adafruit/Adafruit_ADXL343_PCB/Adafruit ADXL343 STEMMA QT.brd

## EAGLE design Adafruit ADXL343 STEMMA QT.brd (2022-03-22)

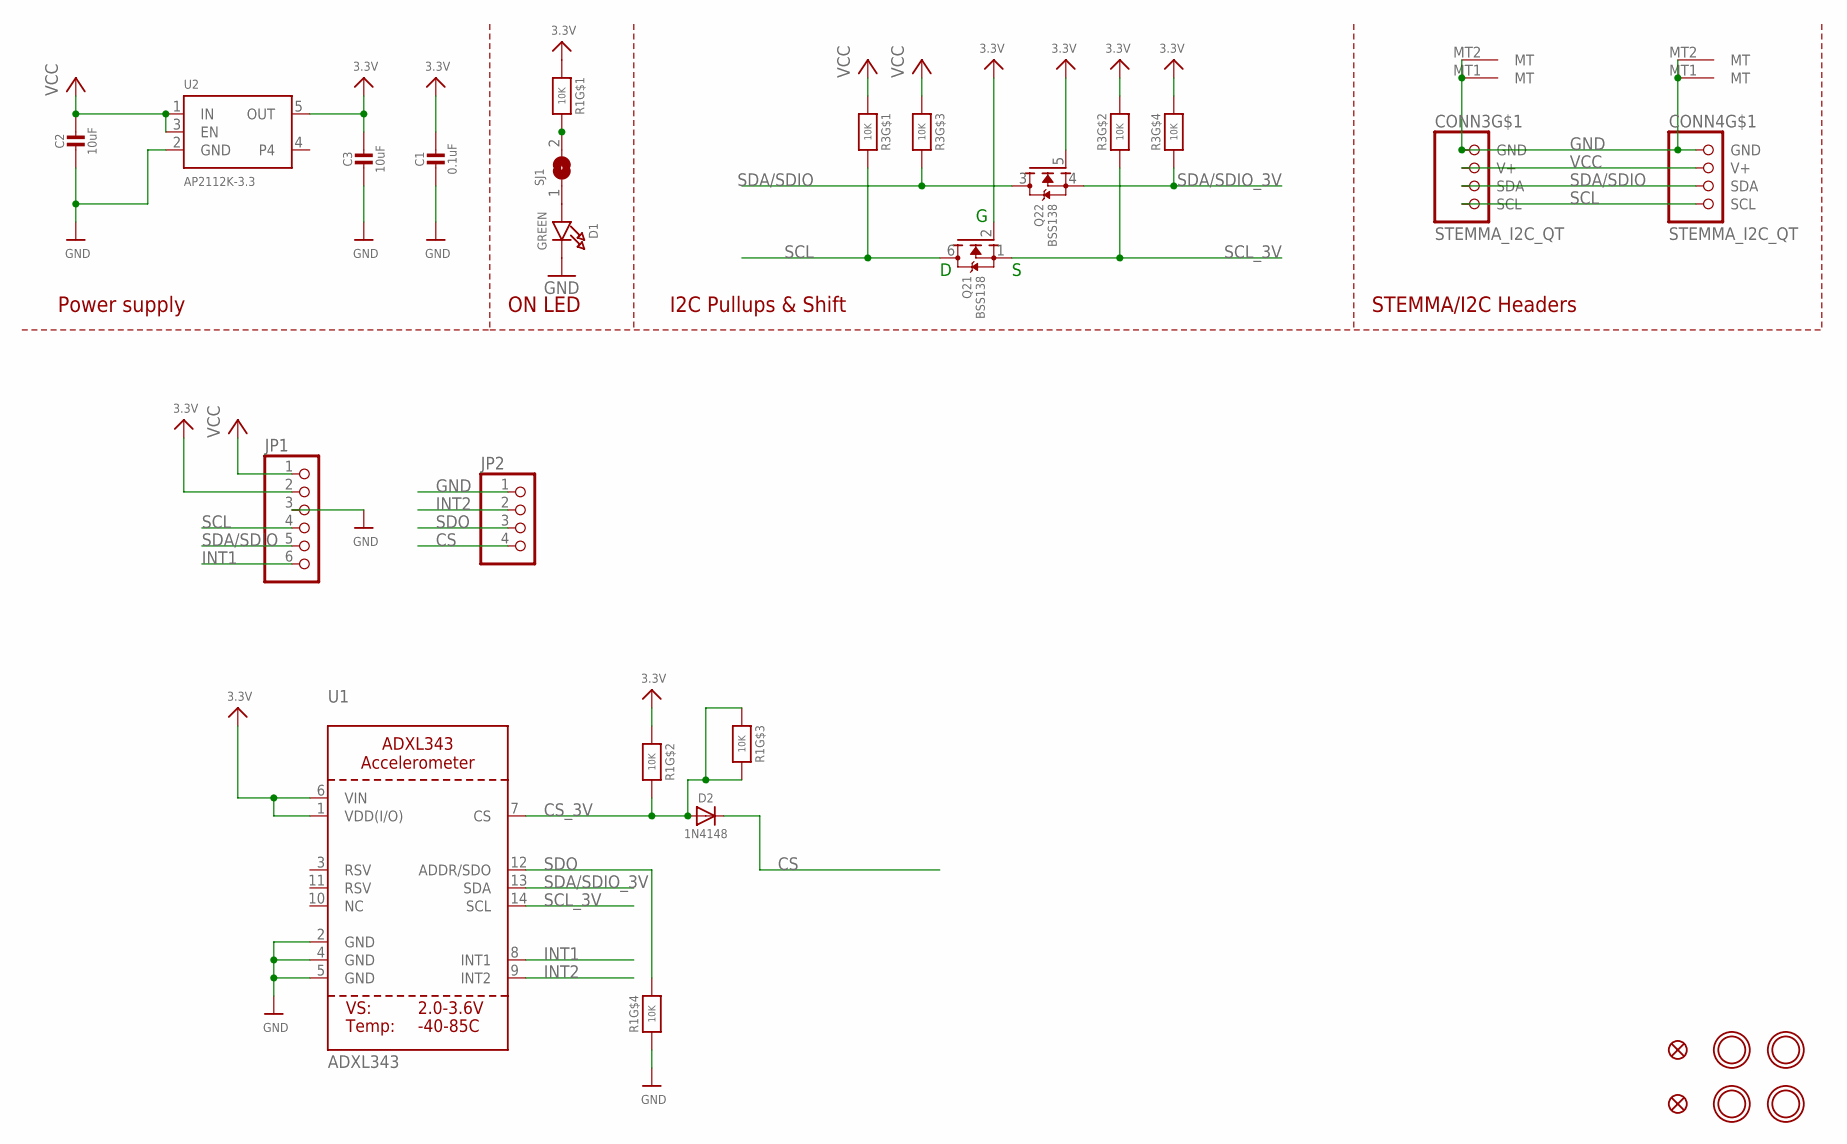
[picture p3: schematic Adafruit ADXL343 STEMMA QT.sch]

Parts:
C1: 0.1uF; 0603-NO
C2: 10uF; _0805MP
C3: 10uF; 0805-NO
CONN3, CONN4: STEMMA_I2C_QT; JST_SH4
D1: GREEN; CHIPLED_0603_NOOUTLINE
D2: 1N4148; SOD-323
FID3, FID4: FIDUCIAL_1MM
JP1: HEADER-1X670MIL; 1X06_ROUND_70
JP2: HEADER-1X4ROUND; 1X04_ROUND
Q2: BSS138; SOT363
R1, R3: 10K; RESPACK_4X0603
SJ1: SOLDERJUMPERCLOSED; SOLDERJUMPER_CLOSEDWIRE
U1: ADXL343; LGA14
U2: AP2112K-3.3; SOT23-5
U$1, U$17, U$19, U$21: MOUNTINGHOLE2.5; MOUNTINGHOLE_2.5_PLATED

Connections:
3.3V: C1.1, C3.1, JP1.2, Q2.2 (G), Q2.5 (G), R1.1, R1.2 (1), R3.2 (1), R3.4 (1), U1.1 (VDD(I/O)), U1.6 (VIN), U2.5 (OUT)
CS: D2.C, JP2.4
CS_3V: D2.A, R1.3 (1), R1.6 (2), R1.7 (2), U1.7 (CS)
GND: C1.2, C2.2, C3.2, CONN3.1 (GND), CONN3.MT1 (MT), CONN3.MT2 (MT), CONN4.1 (GND), CONN4.MT1 (MT), CONN4.MT2 (MT), D1.C, JP1.3, JP2.1, R1.4 (1), U1.2 (GND), U1.4 (GND), U1.5 (GND), U2.2 (GND)
INT1: JP1.6, U1.8 (INT1)
INT2: JP2.2, U1.9 (INT2)
unnamed: R1.8 (2), SJ1.2
unnamed: D1.A, SJ1.1
SCL: CONN3.4 (SCL), CONN4.4 (SCL), JP1.4, Q2.6 (D), R3.8 (2)
SCL_3V: Q2.1 (S), R3.7 (2), U1.14 (SCL)
SDA/SDIO: CONN3.3 (SDA), CONN4.3 (SDA), JP1.5, Q2.3 (D), R3.6 (2)
SDA/SDIO_3V: Q2.4 (S), R3.5 (2), U1.13 (SDA)
SDO: JP2.3, R1.5 (2), U1.12 (ADDR/SDO)
VCC: C2.1, CONN3.2 (V+), CONN4.2 (V+), JP1.1, R3.1, R3.3 (1), U2.1 (IN), U2.3 (EN)

Notes on the sheet:
I2C Pullups & Shift
STEMMA/I2C Headers
ON LED
Power supply

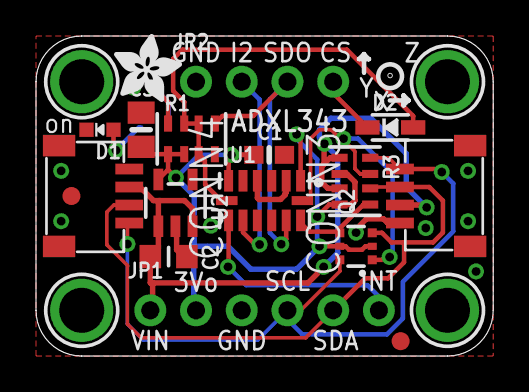
[picture p4: board Adafruit ADXL343 STEMMA QT.brd from above]

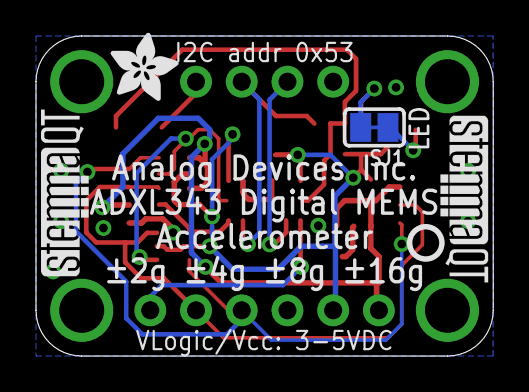
[picture p5: board Adafruit ADXL343 STEMMA QT.brd from below]

Board: 2 copper layers, 25.4 x 17.8 mm, 26 parts (5 on the bottom side), 14 nets.

Other parts of the board:
U$4, U$11: ADAFRUIT_3.5MM
U$25: PCBFEAT-REV-040
U$30, U$31: STEMMAQT
