adafruit/Adafruit_ADXL343_PCB/ADXL343 Rev B.brd

## EAGLE design ADXL343 Rev B.brd (2019-02-04)

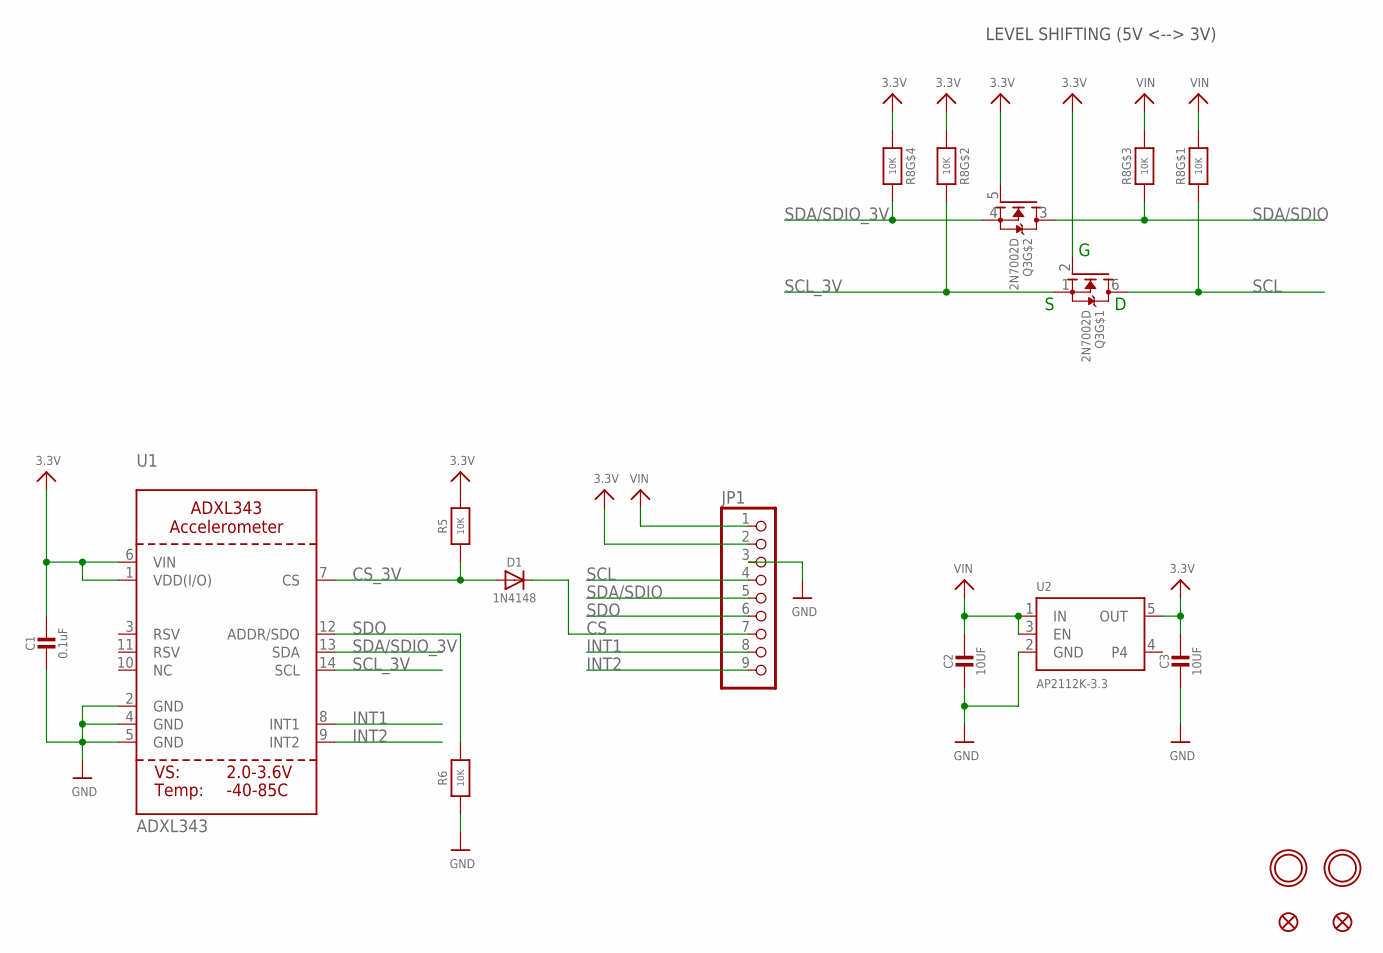
[picture p6: schematic ADXL343 Rev B.sch]

Parts:
C1: 0.1uF; 0603-NO
C2, C3: 10UF; 0805-NO
D1: 1N4148; SOD-323
JP1: HEADER-1X970MIL; 1X09_ROUND_70
Q3: 2N7002D; SOT363
R5, R6: 10K; 0603-NO
R8: 10K; RESPACK_4X0603
U1: ADXL343; LGA14
U2: AP2112K-3.3; SOT23-5
U$1, U$3: FIDUCIAL_1MM
U$4, U$6: MOUNTINGHOLE2.5; MOUNTINGHOLE_2.5_PLATED

Connections:
3.3V: C1.1, C3.1, JP1.2, Q3.2 (G), Q3.5 (G), R5.2, R8.2 (1), R8.4 (1), U1.1 (VDD(I/O)), U1.6 (VIN), U2.5 (OUT)
CS: D1.C, JP1.7
CS_3V: D1.A, R5.1, U1.7 (CS)
GND: C1.2, C2.2, C3.2, JP1.3, R6.1, U1.2 (GND), U1.4 (GND), U1.5 (GND), U2.2 (GND)
INT1: JP1.8, U1.8 (INT1)
INT2: JP1.9, U1.9 (INT2)
SCL: JP1.4, Q3.6 (D), R8.8 (2)
SCL_3V: Q3.1 (S), R8.7 (2), U1.14 (SCL)
SDA/SDIO: JP1.5, Q3.3 (D), R8.6 (2)
SDA/SDIO_3V: Q3.4 (S), R8.5 (2), U1.13 (SDA)
SDO: JP1.6, R6.2, U1.12 (ADDR/SDO)
VIN: C2.1, JP1.1, R8.1, R8.3 (1), U2.1 (IN), U2.3 (EN)

Notes on the sheet:
LEVEL SHIFTING (5V <--> 3V)

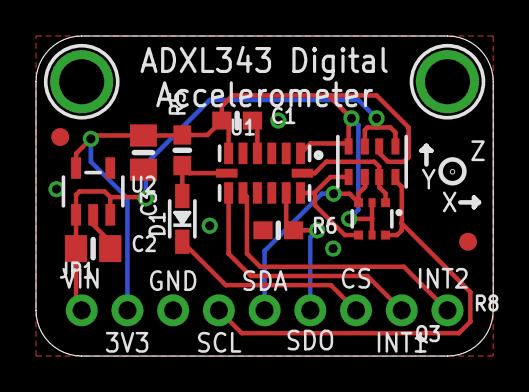
[picture p7: board ADXL343 Rev B.brd from above]

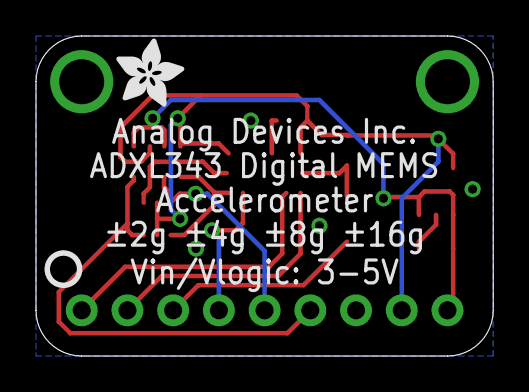
[picture p8: board ADXL343 Rev B.brd from below]

Board: 2 copper layers, 25.4 x 17.8 mm, 17 parts (2 on the bottom side), 12 nets.

Other parts of the board:
U$5: ADAFRUIT_3.5MM
U$7: PCBFEAT-REV-040
