adafruit/Adafruit_ADXL343_PCB/(commit log)

2019-07-17 updated to use cookiecutter for pcb repos
2022-03-22 Updating STEMMA
    [Adafruit ADXL343 STEMMA QT.brd, Adafruit ADXL343 STEMMA QT.sch]
